cbm-instructions/sixtysix/images/Leiterplatte.jpg

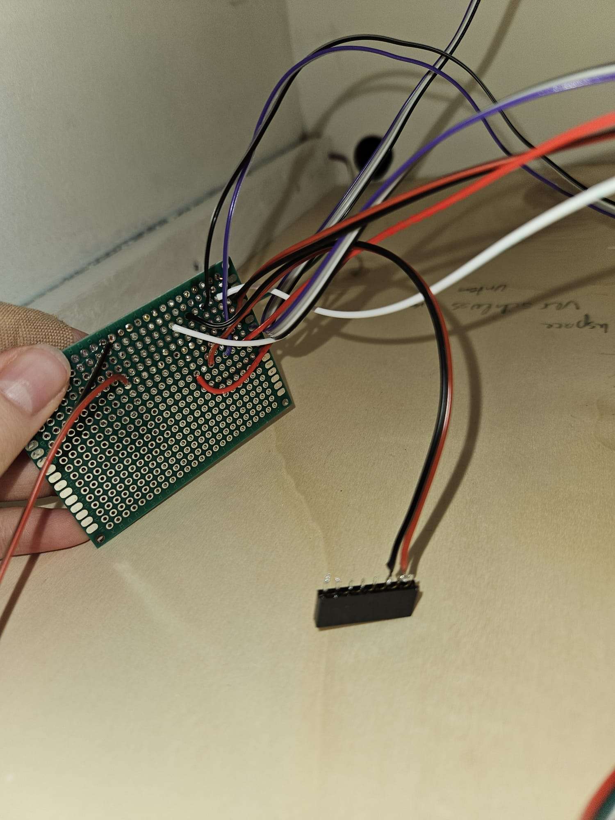
images/Leiterplatte.jpg
