cbm-instructions/sixtysix/images/Servo_Bracket.stl

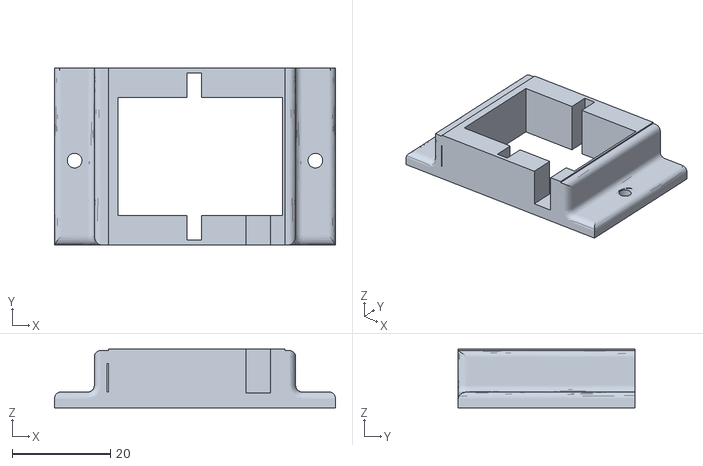
[picture p20: CAD file, 2024-01-30]
images/Servo_Bracket.stl
57.3 x 36.0 x 12.0
