cbm-instructions/sixtysix/images/Sliding_Lock.stl

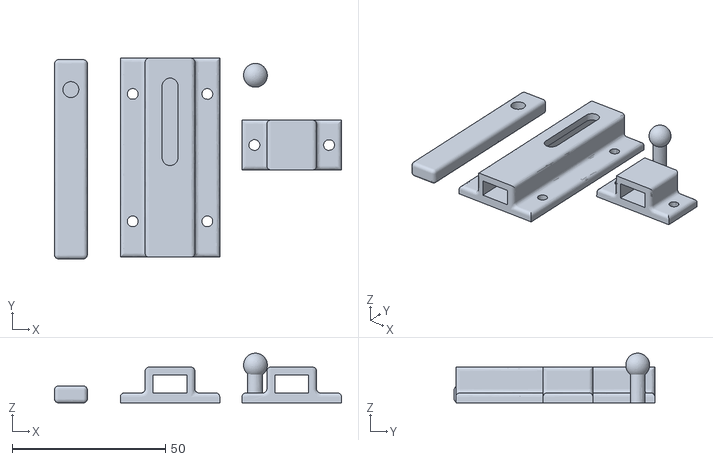
[picture p21: CAD file, 2024-01-30]
images/Sliding_Lock.stl
93.7 x 65.6 x 16.3
