cbm-instructions/sixtysix/code/WIFICam/WifiCam.hpp

#ifndef WIFICAM_HPP
#define WIFICAM_HPP

#include <esp32cam.h>

#include <WebServer.h>

extern esp32cam::Resolution initialResolution;

extern WebServer server;

void
addRequestHandlers();

void
serveStill();

#endif // WIFICAM_HPP
