cbm-instructions/sixtysix/(commit log)

2024-01-23 Add "Arduino Uno" and "ESP32-Cam" Text
2024-01-29 Update and rename asdf.py to Raspberry.py
